nilsrenner/Self-Tuned-Filter/README.md

# Self-Tuned Filter
Backup für die Bachlorarbeit
