nilsrenner/Self-Tuned-Filter/005_Dokumentation/003_Thesis/acronyms.tex

\newacronym{pll}{PLL}{Phase-Locked Loop}%

%\newacronym{digipot}{DP}{Digitalpotentiometer}

\newacronym{opv}{OPV}{Operationsverstärker}%fertig

\newacronym{pd}{PD}{Phasendetektor}%

\newacronym{vco}{VCO}{Voltage-Controlled Oscillator}%

\newacronym{vcf}{VCF}{Voltage-Controlled Filter}%

\newacronym{pcb}{PCB}{Printed Circuit Board}%

\newacronym{mcu}{MCU}{Microcontroller Unit}%

\newacronym{gpio}{GPIO}{General Purpose Input Output}

\newacronym{spi}{SPI}{Serial Peripheral Interface}

\newacronym{adc}{ADC}{Analog Digital Converter}%

\newacronym{ui}{UI}{User Interface}

\newacronym{wlan}{WLAN}{Wireless Local Area Network}

\newacronym{eeprom}{EEPROM}{Electrically Erasable Programmable Read-Only Memory}

\newacronym{http}{HTTP}{Hypertext Transfer Protocol}

\newacronym{html}{HTML}{Hypertext Markup Language}

\newacronym{ip}{IP}{Internet Protocol}

\newacronym{ram}{RAM}{Random Access Memory}

\newacronym{gbw}{GBW}{Gain Bandwidth Product}

%\newacronym{sf}{SF}{Scale Factor}

\newacronym{ic}{IC}{Integrated Circuit}
