nilsrenner/Self-Tuned-Filter/005_Dokumentation/Vorbereitung/report/index.qmd

---
title: "Vorbereitung Bachlorarbeit"
author: 
  - name: Nils Renner
    orcid: 
    email: nrenner@stud.hs-bremen.de
    corresponding: true
    roles: "Lead author"
    affiliation:
      - name: Hochschule Bremen - City University of Applied Sciences (HSB)
        city: Bremen
        state: Germany
        url: https://www.hs-bremen.de  

keyword:
  - Filter Design 
  - PCB

abstract: |
    Lorem ipsum 

date: last-modified
number-sections: true
bibliography: references.bib
---

{{< include content/_sec_Einleitung.qmd >}}
{{< include content/_sec_Theorie_2.qmd >}}
{{< include content/_sec_Charakterisierung.qmd >}}
{{< include content/references.qmd >}}
