nilsrenner/Self-Tuned-Filter/005_Dokumentation/003_Thesis/Theorie/Theorie_alt.pdf

# Kapitel 1

# Theoretische Grundlagen

In diesem Teil werden die bislang im Studium erlangten Kenntnisse noch einmal aufgegriffen. Bei der Dokumentation dieser wurden allerdings auch immer wieder neue Erkenntnisse gewonnen.

Konventionelle Filterschaltungen basieren meist auf Kondensatoren und Induktivitäten. Während Kondensatoren sehr kompakt aufgebaut und problemlos in integrierten Schaltungen realisiert werden können, stellen Induktivitäten in dieser Hinsicht eine Herausforderung dar. Induktivitäten sind groß und lassen sich nur schwer miniaturisieren, was den Einsatz in modernen elektronischen Systemen erschwert. Zudem weisen Induktivitäten parasitäre Eigenschaften auf, die das Filterverhalten insbesondere bei höheren Frequenzen negativ beeinflussen können.

Eine gute Lösung für diese Problematik sind opv, die durch die externe Verschaltung von Kondensatoren und Widerständen die Funktion von Induktivitäten übernehmen können. Durch die geschickte Kombination dieser drei Bauelemente lassen sich vielfältige Filterstrukturen auf kleinem Raum realisieren. Filter auf Basis von opv werden als aktive Filter bezeichnet, da sie im Gegensatz zu passiven Filtern eingehende Signale verstärken können und deshalb eine externe Spannungsversorgung benötigen, um den opv mit Energie zu versorgen.[1]

1

Nils Renner (5197659) | Vorbereitung Bachelorthesis

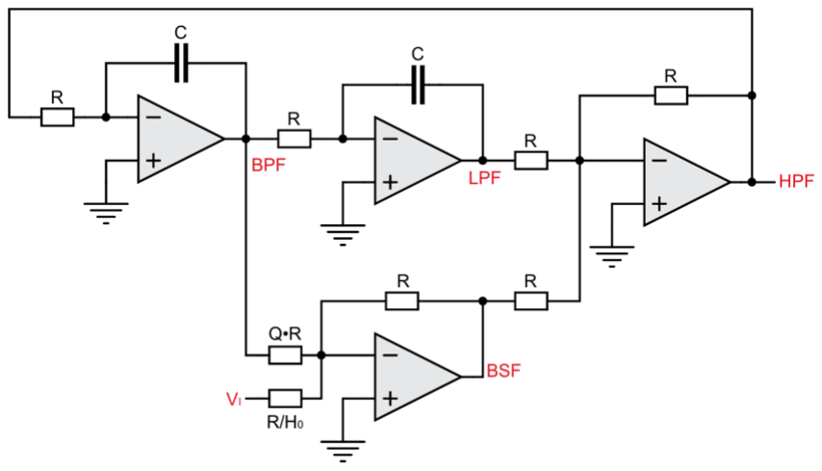
[picture p44: figure]

Abbildung 1.1: Biquadratische Filterstruktur [2]

Eine dieser aktiven Filterstrukturen ist der sogenannte Biquad-Filter, der in der Lage ist, verschiedene Filtertypen wie Tiefpass, Hochpass, Bandpass und Bandsperre innerhalb einer Schaltung bereitzustellen.

Der Biquad-Filter ist wie der Name schon andeutet ein Filter zweiter Ordnung, der aus zwei Integratoren und zwei Addierern besteht. Durch die Verschaltung dieser opv wie in Abbildung 1.1 zu erkennen, liegt am Ausgang jedes opv ein Signal vor, was eine andere Filtercharakteristik aufweist. Durch die Wahl des Ausgangs kann somit die gewünschte Filterung ausgegeben werden.

Zur mathematischen Beschreibung des Systems werden die Übertragungsfunkionen der einzelnen Filtertypen mittels der Laplace-Transformation, unter Verwendung des idealisierten opv-Modells, hergeleitet. Damit gilt für den Integrierer:

Vin

R
−

+

Vout

C

Abbildung 1.2: Invertierender Integrator

Vout(s) = −

Vin(s)
sRC | (1.1)

Und für den invertierenden Addierer:

Vout = −R2

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
(1.2)

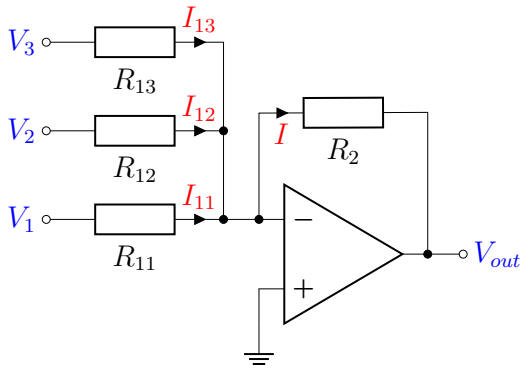
[picture p45: figure]
Vout

Abbildung 1.3: Invertierender Addierer

Durch die Kombination dieser Teilschaltungen lassen sich die Übertragungsfunktionen der einzelnen glsopv-Ausgänge herleiten. Dabei steht Q für den Gütefaktor und der Verstärkungsfaktor wird durch H0 repräsentiert.

V1 = −(V3 + V4) | (1.3)

V2 = −

1
s

ω0 · V1

| (1.4)

V3 = −

1
s

ω0 · V2

| (1.5)

V4 = −

V2
Q

+ H0 · Vi

| (1.6)

Werden diese Gleichungen so ineinander eingesetzt, dass sie dem Schaltbild des Biquad-Filters (1.1) entsprechen, lassen sich die Übertragungsfunktionen der vier Filtertypen herleiten. Die einzelnen Schritte der Herleitung werden im Abschlussbericht des Moduls ANS [3] ausführlicher besprochen.

- Tiefpass:

V3
Vi

=

H0
1 + s
ω0Q +

s

2
ω

2
0

(1.7)

- Hochpass:

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
1 + s
ω0Q +

s

2
ω

2
0

(1.8)

- Bandpass:

V2
Vi

=

−H0

s
ω0
1 + s
ω0Q +

s

2
ω

2
0

(1.9)

- Bandsperre:

V4
Vi

=

−H0

1 + s

2
ω

2/0

1 + s
ω0Q +

s

2
ω

2
0

(1.10)

Gut zu erkennen ist hierbei, dass alle Übertragungsfunktionen den gleichen Nenner besitzen. Der Zähler unterscheidet sich je nach Filterart.

## 1.1 Einfluss der Bauteilgrößen und Parameter auf das Filterverhalten

Die Werte der im Biquad eingesetzten Widerstände und Kondensatoren bestimmen die charakteristischen Größen des Filters. Insbesondere beeinflussen sie die Mittenfrequenz ω0, die Filtergüte Q und die maximale Verstärkung H0. Durch die gezielte Auswahl der Bauteilwerte lässt sich das Filterverhalten auf die spezifischen Anforderungen einer Anwendung abstimmen.

Die Mittenfrequenz ω0 ergibt sich bei idealiserten Schaltungen nach folgender Formel:

ω0 =

1
RC | (1.11)

Durch genauere Betrachtung in der Vorbereitungsphase auf diese Thesis fiel auf, dass R sich nur durch den Wert der beiden Vorwiderstände der Integratoren ergibt, nicht aber durch die Widerstände der Addierer. Dieser Zusammenhang war vorher nicht klar, weswegen im damaligen Schaltungsdesign die Kondensatoren geändert wurden (Anstatt 8 Widerstände)um die Mittenfrequenz zu verschieben. C beschreibt die Kapazität der beiden Kondensatoren in den Integratoren. Der durch die Gleichung 1.11 gezeigte Zusammenhang kann nun dafür verwendet werden, die Mittenfrequenz auf den gewünschten Wert einzustellen.

Der Gütefaktor beeinflusst im Zeitbereich die Resonanz und Dämpfung des Filters. Je nach Wert von Q lassen sich drei unterschiedliche Dämpfungsfälle anhand der Impulsantwort unterscheiden:

- Schwingfall (Q > 1
2

): Konjugiert-komplexe Pole, gedämpftes Schwingungsverhalten:

s1,2 = −

ω0
2Q

± jω0

r
1 −

1
4Q²
- Aperiodischer Grenzfall (Q =

1/2): Doppelter reeller Pol, kritische Dämpfung:

s1,2 = −ω0

- Kriechfall (Q < 1
2

): Zwei reelle Pole, träges (überdämpftes) Verhalten:

s1,2 = −

ω0
2Q

± ω0

r
1
4Q²

− 1

Die Filtergüte Q beeinflusst ebenfalls das Frequenzverhalten des Filters. Dabei unterscheidet sich der Zusammenhang zwischen Güte und Bandbreite je nach Filtertyp.

Bei Hoch- und Tiefpassfiltern charakterisiert Q die Flankensteilheit im Übergangsbereich um die Grenzfrequenz ωc. Eine Erhöhung des Gütefaktors führt zu einer steileren Filterflanke und zu einer stärkeren Dämpfung außerhalb des Durchlassbereichs. Zudem ergibt sich ab einer Güte von Q > √

1
2

eine Resonanzüberhöhung (Überschwinger) an der Mittenfrequenz.

Im Gegensatz dazu verfügen Bandpass- und Bandsperrfilter über eine deutlich ausgeprägte Mittenfrequenz ω0, welche das Zentrum des Durchlass- bzw. Sperrbereichs markiert. Die Bandbreite ∆ω beschreibt den Abstand zwischen den beiden 3 dB-Grenzfrequenzen. Die folgende Gleichung beschreibt den Zusammenhang zwischen Güte, Bandbreite und Mittenfrequenz.[4]

∆ω =

ω0
Q

(1.12)

Eine größere Güte Q führt also zu einer schmaleren Bandbreite und zu einer stärker ausgeprägten Verstärkung bzw. Dämpfung um die Mittenfrequenz.

hier könnte noch eine schöne überleitung zur NS und PS in der s-Ebene hinein. -> gehe ich darauf später noch mal ein?

Der Verstärkungsfaktor H0 wirkt sich hingegen nur auf die Amplitudenhöhe des Filters aus, ohne die Frequenzcharakteristik zu verändern. Ein höherer Verstärkungsfaktor führt zu einer stärkeren Signalverstärkung im Durchlassbereich des Filters.

sollte hier die bestimmung der Grenzfrequenz hin? => habe das allerdings zur vorbereitung gemacht und nicht im 6. Semester

## 1.2 Grenzfrequenz und Mittenfrequenz

sollte warscheinlich vor dem anderen Kapitel stehen.

Da in der Vorbereitungsphase zu dieser Thesis aufgefallen ist, dass die Begriffe Grenzfrequenz ωc und Mittenfrequenz ω0 in der Vorarbeit aus dem letzten Semester nicht immer eindeutig verwendet wurden, wird im Folgenden kurz auf deren Definition eingegangen.

Im ALSK-Pro-Manual werden für die Übertragungsfunktionen immer die Kreisfrequenzen verwendet, weswegen auch in dieser Arbeit hauptsächlich Kreisfrequenzen verwendet. Die Grenzfrequenz ωc beschreibt dabei die Kreisfrequenz, bei der der Betrag der Übertragungsfunktion eines Filters auf √

1
2

bezogen auf den Maximalwert abgefallen bzw. bei Bandsperren angestiegen ist und entspricht damit dem −3 dB-Punkt (bzw. 3 dB-Punkt bei BS) des Amplitudengangs.

Die Mittenfrequenz ω0 entspricht der Resonanzfrequenz des Filters. Bei Bandpass- und Bandsperrfiltern enspricht diese Frequenz dem Maximum bzw. Minimum des Amplitudengangs. Bei Hoch- und Tiefpässen sind Grenz- und Mittenfrequenz im Allgemeinen nicht identisch. Die Außnahme stellt dabei der Butterworth-Filter da, für diesen gilt ω0 = ωc.

Für eine Güte Q > √

1
2

ist die Mittenfrequenz auch bei Hoch- und Tiefpässen erkennbar. Dort tritt eine Resonanzüberhöhung im Amplitudengang auf, deren Maximum bei der Mittenfrequenz liegt. Beim Bandpass liegt die Mittenfrequenz im Zentrum des Durchlassbereichs, während die unteren und oberen Grenzfrequenzen die Bandbreite des Übertragungsbereichs begrenzen.
