nilsrenner/Self-Tuned-Filter/005_Dokumentation/003_Thesis/Fazit/Fazit.tex

\documentclass[../main_config.tex]{subfiles}
\begin{document}

\chapter{Fazit und Ausblick}

\end{document}
