nilsrenner/Self-Tuned-Filter/005_Dokumentation/003_Thesis/analog_multiplier/bsb_einfacher_mulitplizierer.pdf

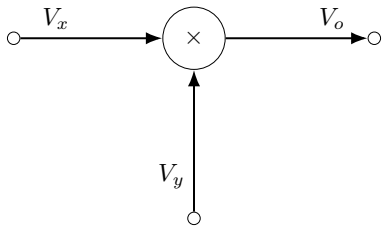
[picture p47: figure]
