nilsrenner/Self-Tuned-Filter/005_Dokumentation/003_Thesis/Theorie/bsb_produkt.pdf

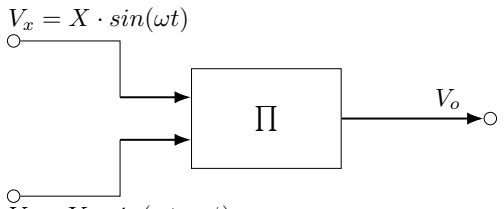
[picture p48: figure]
Vx = X · sin(ωt)

Vy = Y · sin(ωt + ϕ)
