nilsrenner/Self-Tuned-Filter/005_Dokumentation/003_Thesis/Theorie/sb_phasendetektor.pdf

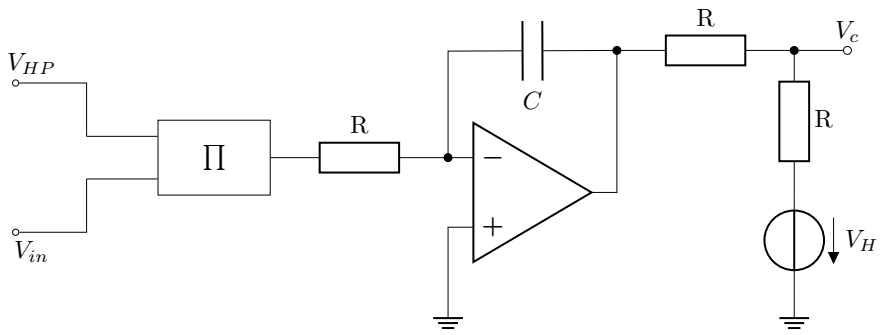
[picture p49: figure]
VHP Vin
