nilsrenner/Self-Tuned-Filter/005_Dokumentation/003_Thesis/Theorie/sb_vcintegrator.pdf

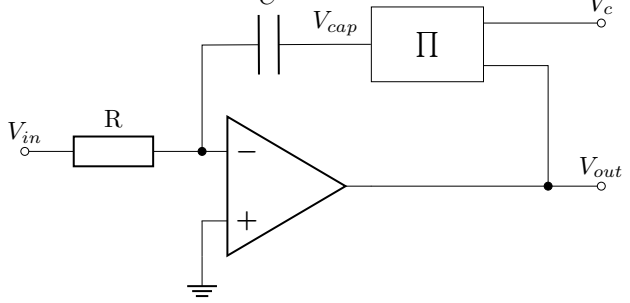
[picture p50: figure]
Vin; Vcap; Vout

C
Vc
