nilsrenner/Self-Tuned-Filter/005_Dokumentation/003_Thesis/Theorie/sb_w0_herleitung.pdf

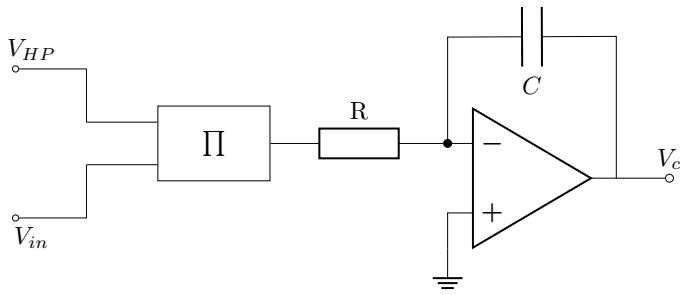
[picture p51: figure]
VHP Vin
