nilsrenner/Self-Tuned-Filter/005_Dokumentation/003_Thesis/Theorie/bsb_multi_funktionell.pdf

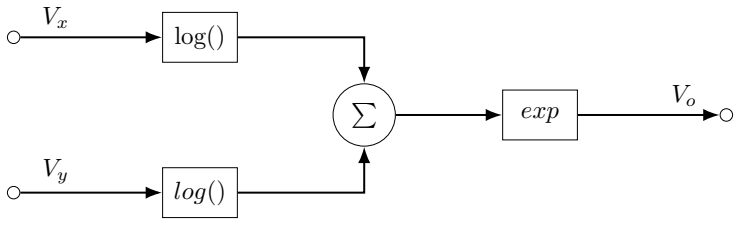
[picture p52: figure]
log(); exp
