nilsrenner/Self-Tuned-Filter/001_Simulation_und_Schaltungsentwurf/002_Symbols_and_Footprints/.svg2shenzhen-cache/images/F.SilkS_g3.png

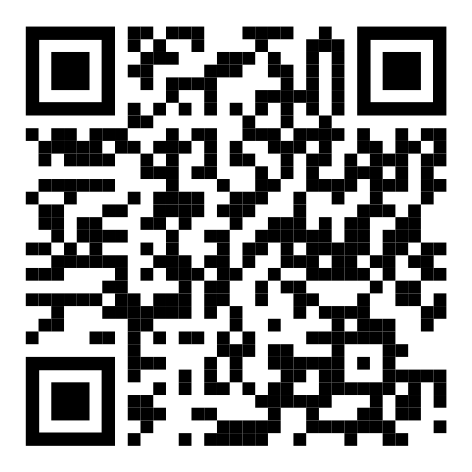
001_Simulation_und_Schaltungsentwurf/002_Symbols_and_Footprints/.svg2shenzhen-cache/images/F.SilkS_g3.png
