nilsrenner/Self-Tuned-Filter/005_Dokumentation/001_Bilder/Figure_7.png

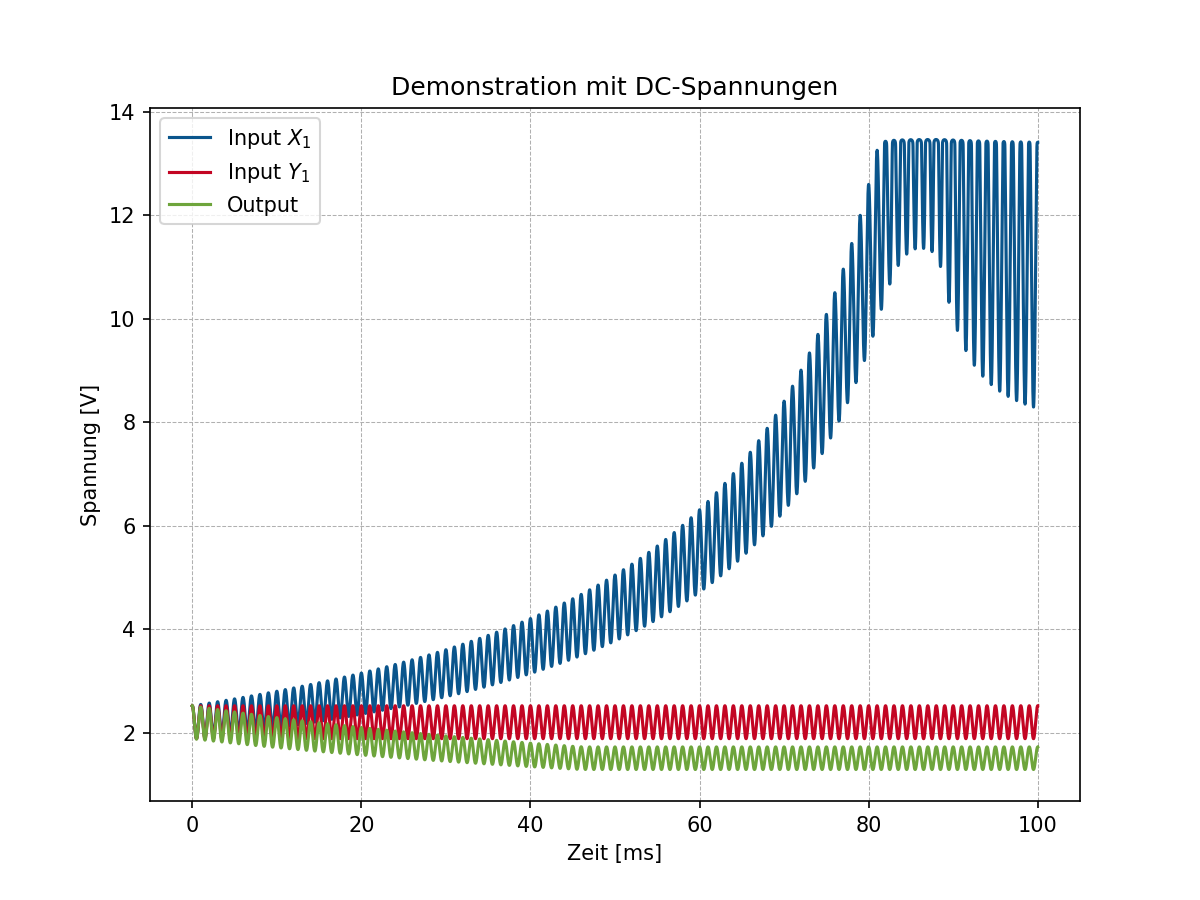
005_Dokumentation/001_Bilder/Figure_7.png
