nilsrenner/Self-Tuned-Filter/005_Dokumentation/001_Bilder/versch_freq_3.png

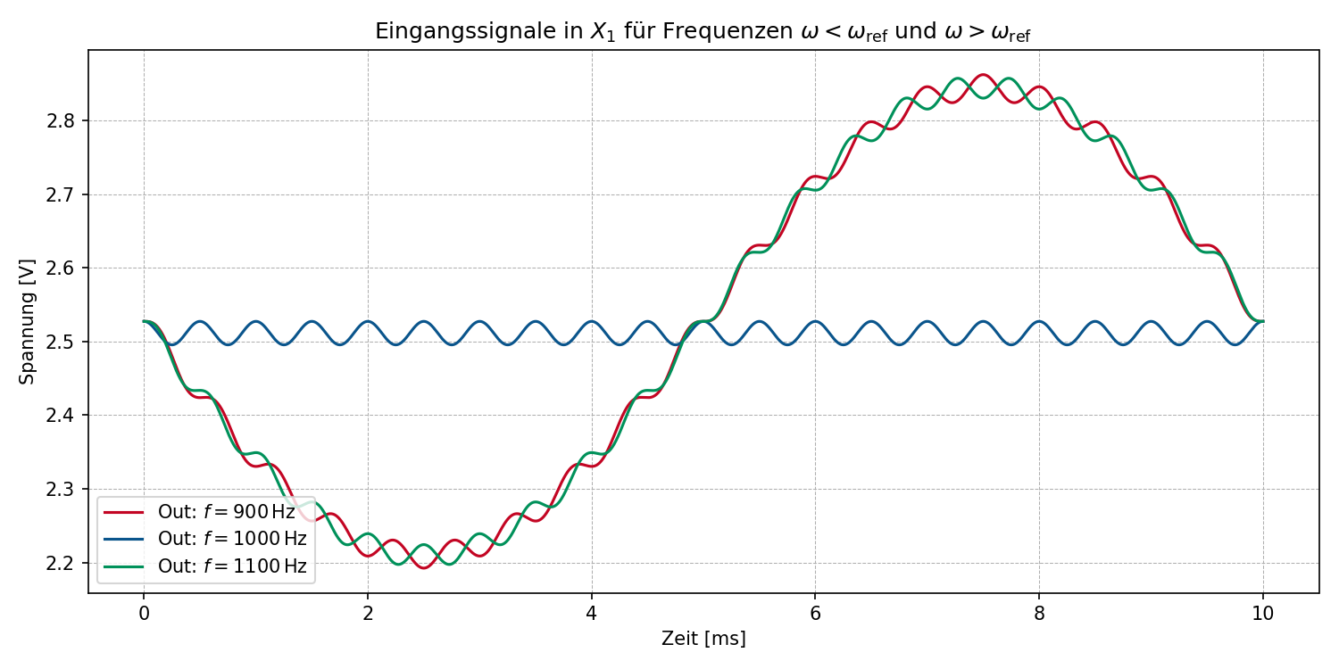
005_Dokumentation/001_Bilder/versch_freq_3.png
