nilsrenner/Self-Tuned-Filter/005_Dokumentation/002_Expose/Pictures/zp_ba.png

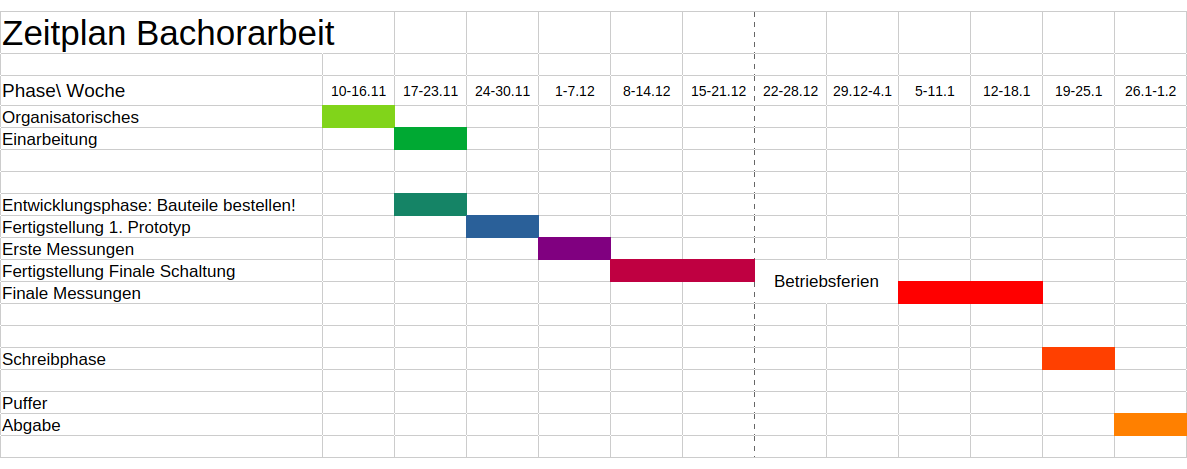
005_Dokumentation/002_Expose/Pictures/zp_ba.png
