nilsrenner/Self-Tuned-Filter/005_Dokumentation/003_Thesis/Bilder/ac_multi_pd.png

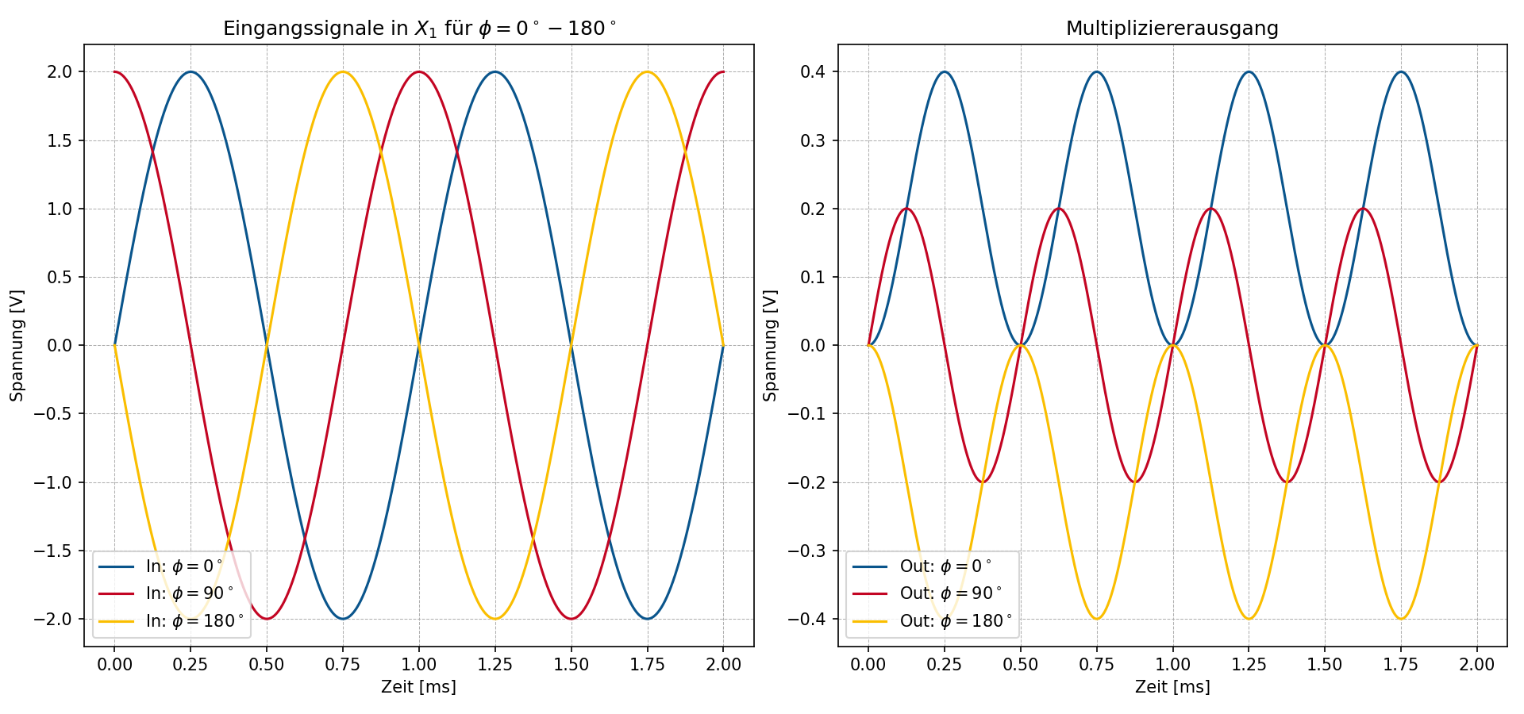
005_Dokumentation/003_Thesis/Bilder/ac_multi_pd.png
