nilsrenner/Self-Tuned-Filter/005_Dokumentation/003_Thesis/Bilder/dc_multi.png

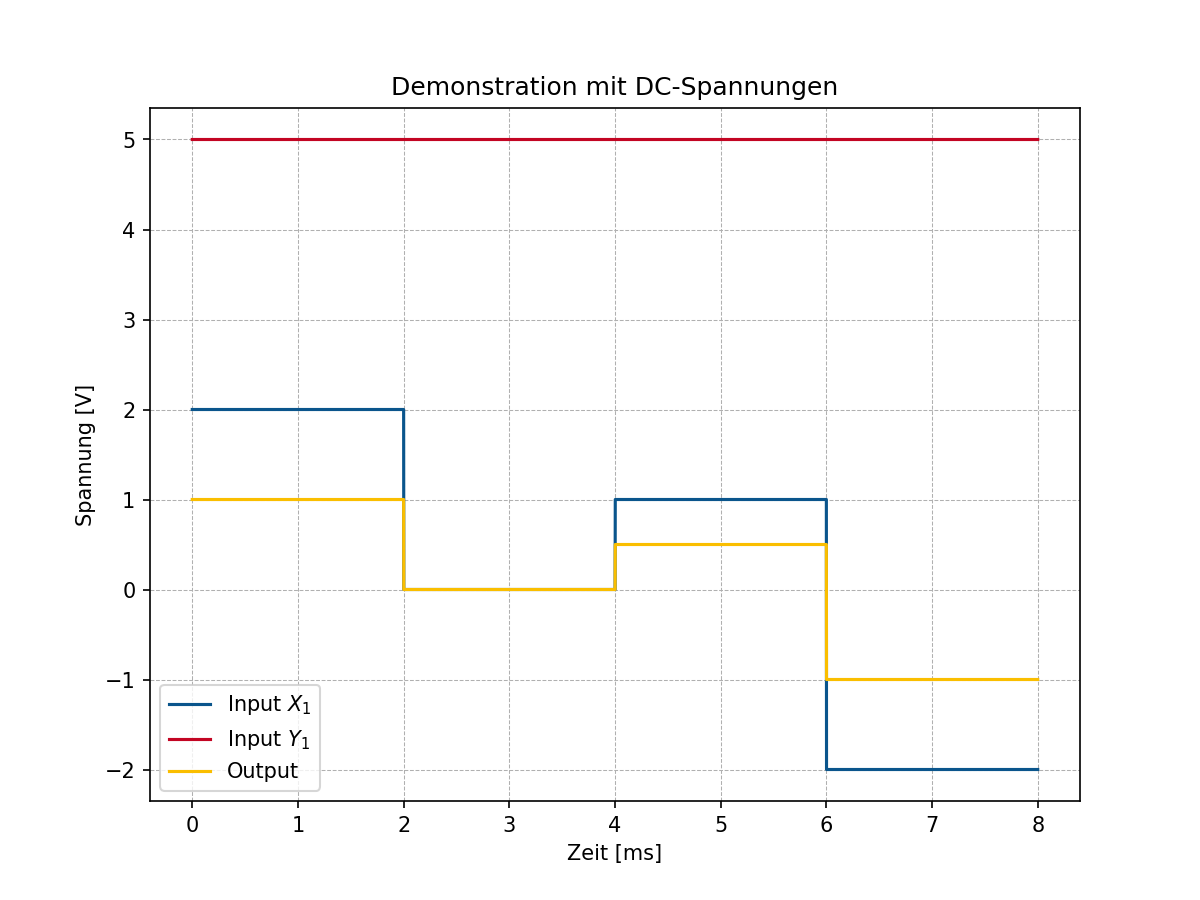
005_Dokumentation/003_Thesis/Bilder/dc_multi.png
