nilsrenner/Self-Tuned-Filter/005_Dokumentation/003_Thesis/Bilder/pd_op_out.png

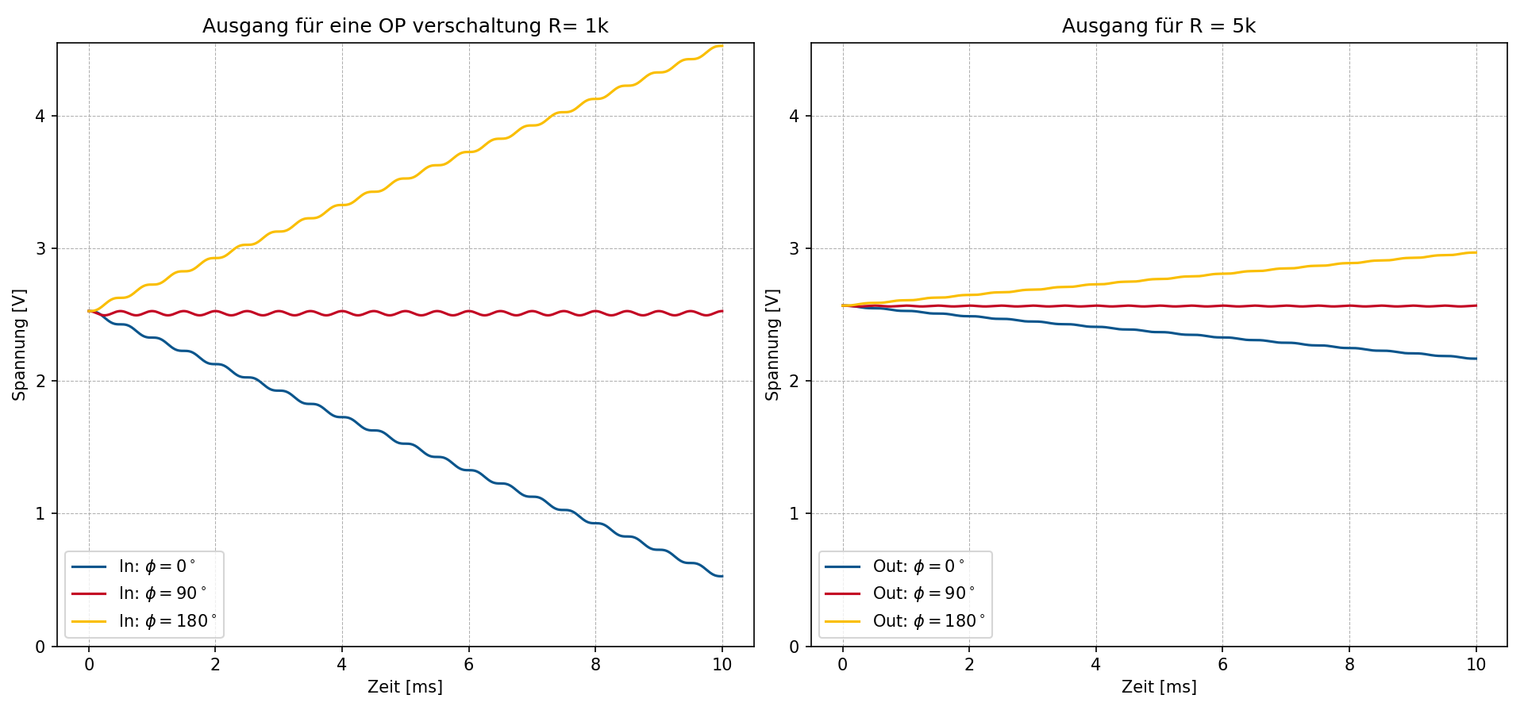
005_Dokumentation/003_Thesis/Bilder/pd_op_out.png
