nilsrenner/Self-Tuned-Filter/005_Dokumentation/003_Thesis/Bilder/phase2omega3.png

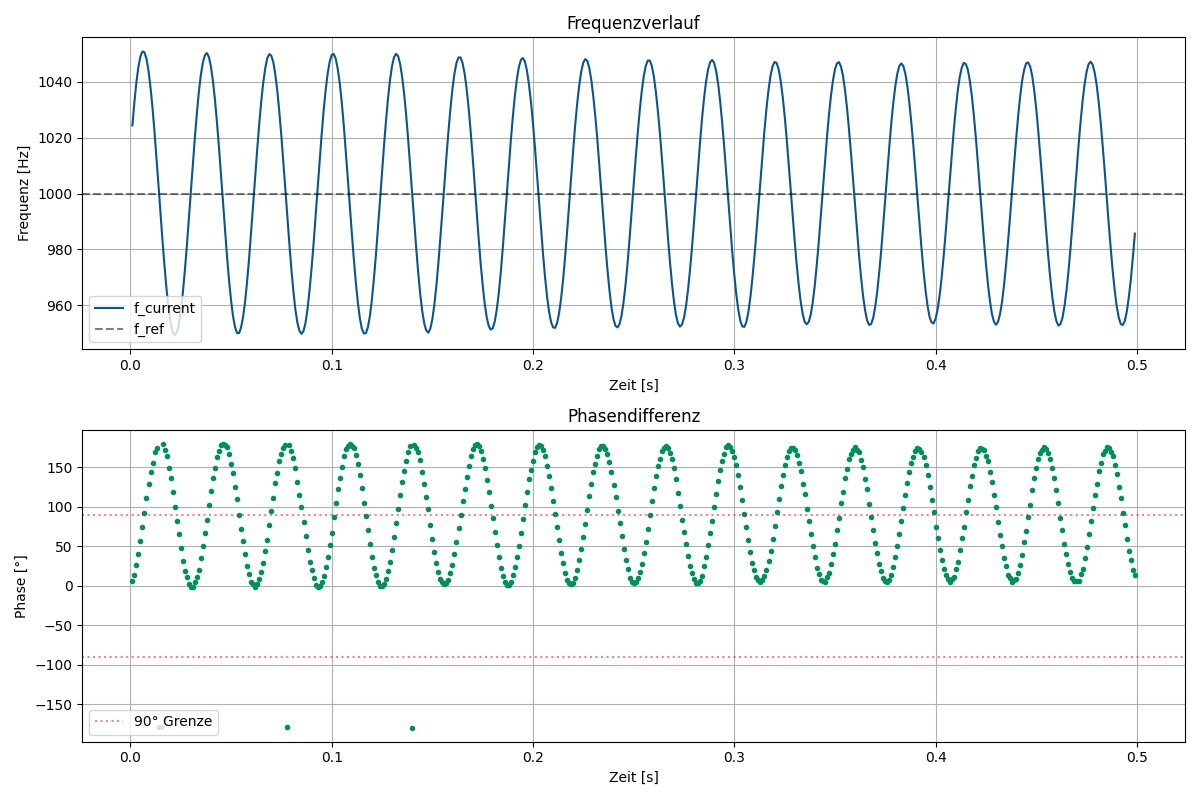
005_Dokumentation/003_Thesis/Bilder/phase2omega3.png
