nilsrenner/Self-Tuned-Filter/005_Dokumentation/003_Thesis/Bilder/phasencharakteristik_multi2.png

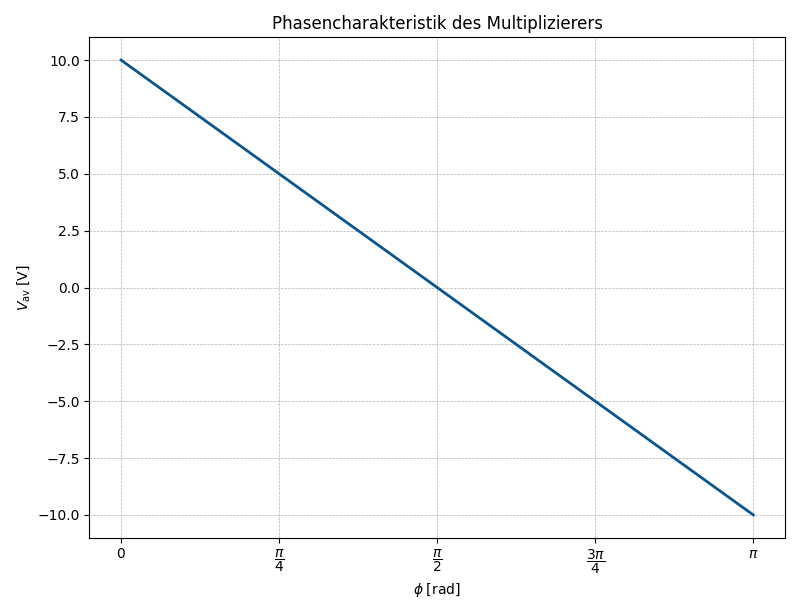
005_Dokumentation/003_Thesis/Bilder/phasencharakteristik_multi2.png
