nilsrenner/Self-Tuned-Filter/005_Dokumentation/003_Thesis/Bilder/phasengang_biquad_sem6.png

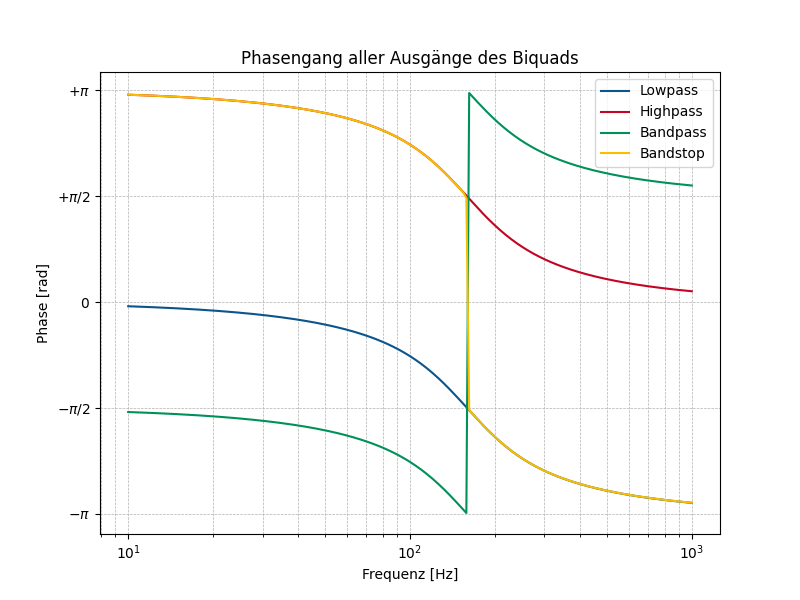
005_Dokumentation/003_Thesis/Bilder/phasengang_biquad_sem6.png
