nilsrenner/Self-Tuned-Filter/005_Dokumentation/003_Thesis/Bilder/sensitivität1.png

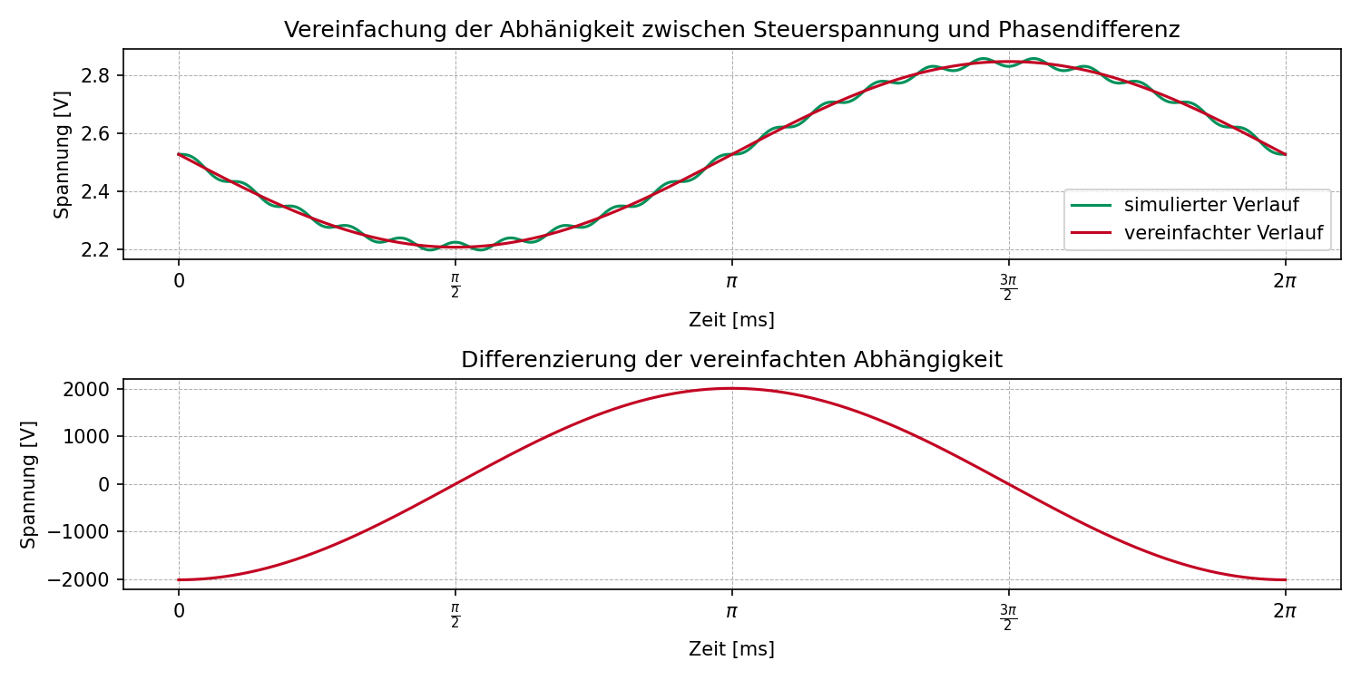
005_Dokumentation/003_Thesis/Bilder/sensitivität1.png
