nilsrenner/Self-Tuned-Filter/001_Simulation_und_Schaltungsentwurf/002_Symbols_and_Footprints/MCP4261-104E_P.step

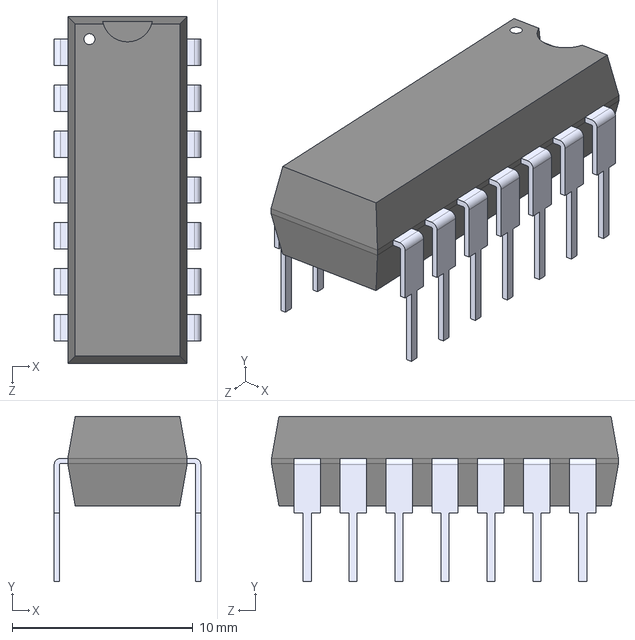
[picture p70: CAD file, 2025-10-15]
001_Simulation_und_Schaltungsentwurf/002_Symbols_and_Footprints/MCP4261-104E_P.step
8.10 x 9.14 x 19.2 mm
