nilsrenner/Self-Tuned-Filter/001_Simulation_und_Schaltungsentwurf/008_LTSpice/Experiment_05.asc

C1: cap; 200n
C2: cap; 1µ
C3: cap; 100n
R1: res; 1k
R2: res; 2k
R3: res; 1k
R4: res; 1k
R5: res; 1k
R6: res; 1k
R7: res; 64k
R8: res; 500
R9: res; 100k
R10: res; 10
R11: res; 1k
U1: opamp2; tl082
U2: opamp2; tl082
U3: opamp2; tl082
U4: opamp2; tl082
U5: mpy634
U6: mpy634
U7: mpy634
U8: opamp2; tl082
V1: voltage; PULSE(-100m 100m 0 1n 1n 500µ 1m); AC 1 0
V2: voltage; 10
V3: voltage; 10
V4: voltage; {Vx4}
VDD1: voltage; 15
VE1: voltage; 10
VSS1: voltage; 15
Named nets: 0, V+, V-, vdd, vss, ve
.ac dec 101 50 10k
.inc tl082.cir
.inc mpy634.cir
;tran 60m
.step param Vx4 1 100 20
