nilsrenner/Self-Tuned-Filter/001_Simulation_und_Schaltungsentwurf/008_LTSpice/Experiment_05_DC_VF3.asc

C1: cap; {C}
C2: cap; {C}
C3: cap; {Cx3}
R1: res; {R}
R2: res; {R}
R3: res; 1k
R4: res; {R_C}
R5: res; 1k
R6: res; 1k
R7: res; 10k
R8: res; 100k
R9: res; 1k
R10: res; 100
R11: res; 10
U1: opamp2; tl082
U2: opamp2; tl082
U3: opamp2; tl082
U4: opamp2; tl082
U5: opamp2; tl082
U6: mpy634
U7: mpy634
U8: mpy634
V3: voltage; 2.8
V_OP+: voltage; 10
V_OP-: voltage; 10
VDD1: voltage; 10
VE1: voltage; 10
VG1: voltage; PULSE(-100m 100m 0 1n 1n 500µ 1m); AC 1 0
VSS1: voltage; 10
Named nets: 0, V+, V-, vdd, vss, ve, V_F1, V_F2, V_TP, V_HP, V_F3
;ac dec 1001 50 25k
.inc tl082.cir
.inc mpy634.cir
.tran 0 1.5 0
;step param R_C list 1k 25k 100k
.param C = 650n R = 1k Cx3 = 100n R_C = 1k
;dc V3 0 5 0.1
