nilsrenner/Self-Tuned-Filter/001_Simulation_und_Schaltungsentwurf/008_LTSpice/Integrator mit Quelle am Ausgang.asc

C1: cap; 1µ
R1: res; 100
R2: res; 10
R3: res; 10k
U1: opamp2; tl082
V1: voltage; 1
V_OP1: voltage; 10
V_OP2: voltage; 10
VG1: voltage; PULSE(-100m 100m 0 1n 1n 500µ 1m); AC 1 0
Named nets: 0, V+, V-, V_F3, VG1
.tran 0 100m 0
.inc tl082.cir
