nilsrenner/Self-Tuned-Filter/001_Simulation_und_Schaltungsentwurf/Schaltungsentwurf_v2/Schaltungsentwurf_v2/Schaltungsentwurf_v2.kicad_pcb

## KiCad design 001_Simulation_und_Schaltungsentwurf/Schaltungsentwurf_v2/Schaltungsentwurf_v2/Schaltungsentwurf_v2.kicad_pcb (2026-01-26)

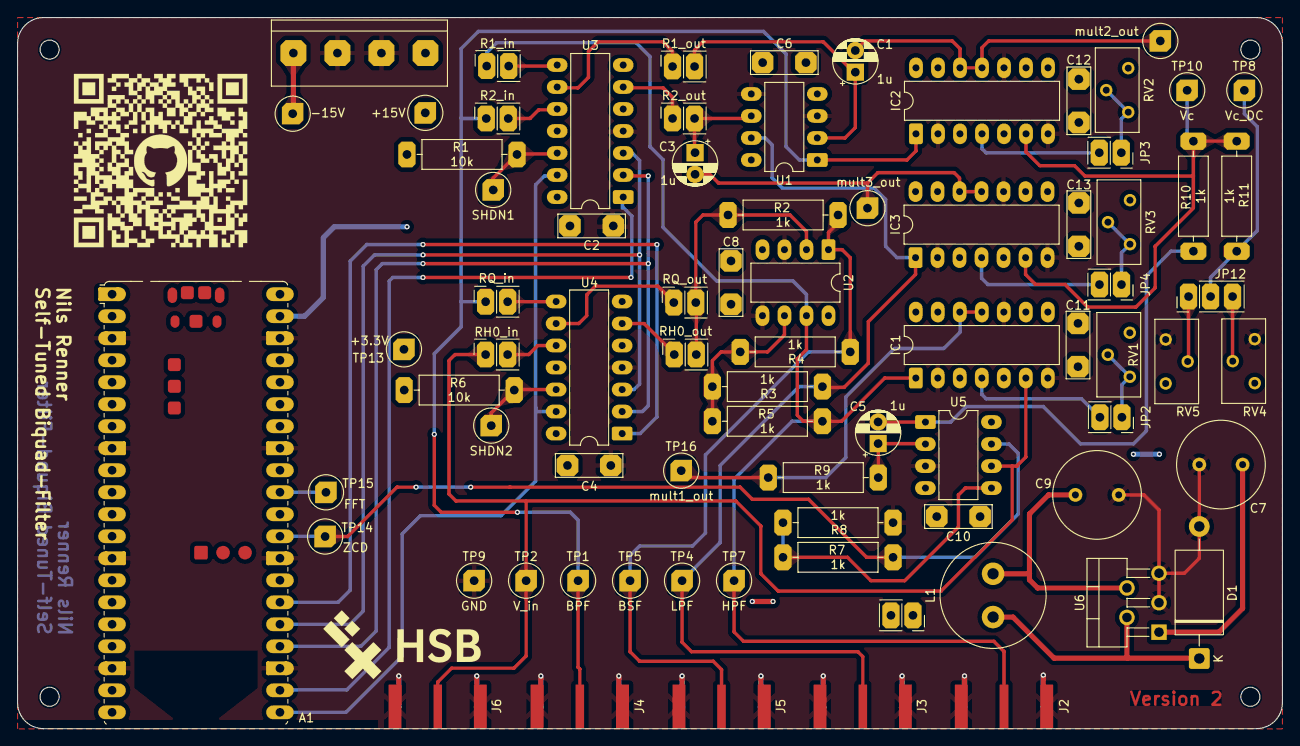
[picture p71: board Schaltungsentwurf_v2.kicad_pcb from above]

Board: 4 copper layers, 146.0 x 82.1 mm, 84 parts (1 on the bottom side), 48 nets.

Parts:
A1: RaspberryPi_Pico_W; RaspberryPi_Pico_W_THT
C1, C3, C5: 1u; 1-10uF
C2, C4, C6, C8, C10, C11, C12, C13: 100n; 100nF
C7: 470uF; C_Radial_D10.0mm_H16.0mm_P5.00mm
C9: 330uF; C_Radial_D10.0mm_H16.0mm_P5.00mm
D1: 1N5820; D_DO-27_P15.24mm_Horizontal
H1, H2, H3, H4: MountingHole; MountingHole_2.2mm_M2_DIN965
IC1, IC2, IC3: MPY634KP; DIP_14
J1: Screw_Terminal_01x04; Terminal 4 Pol
J2, J3, J4, J5, J6: Conn_Coaxial; BNC Edge Mount
JP1: R1_in; Connector 2 Pin 2.54mm
JP2, JP3, JP4, JP13: Connector 2 Pin 2.54mm
JP5: R1_out; Connector 2 Pin 2.54mm
JP6: R2_in; Connector 2 Pin 2.54mm
JP7: RQ_in; Connector 2 Pin 2.54mm
JP8: RH0_in; Connector 2 Pin 2.54mm
JP9: R2_out; Connector 2 Pin 2.54mm
JP10: RQ_out; Connector 2 Pin 2.54mm
JP11: RH0_out; Connector 2 Pin 2.54mm
JP12: Jumper3; Connector 3 Pin 2,54mm
L1: 68uH; L_Radial_D12.0mm_P5.00mm_Fastron_11P
R1, R6: 10k; Resistor
R2, R3, R4, R5, R7, R8, R9, R10, R11: 1k; Resistor
RV1, RV2, RV3: 10k; Potentiometer_Bourns_3296Y_Vertical
RV4, RV5: 100k; Potentiometer_Bourns_3296Y_Vertical
Ref**: Val**; git_qr
Ref**#2: Val**; logo_nils
TP1: BPF; TestPoint
TP2: V_in; TestPoint
TP3: SHDN1; TestPoint
TP4: LPF; TestPoint
TP5: BSF; TestPoint
TP6: SHDN2; TestPoint
TP7: HPF; TestPoint
TP8: Vc_DC; TestPoint
TP9: GND; TestPoint
TP10: Vc; TestPoint
TP11: +15V; TestPoint
TP12: -15V; TestPoint
TP13: +3.3V; TestPoint
TP14: ZCD; TestPoint
TP15: FFT; TestPoint
TP16: mult1_out; TestPoint
TP17: mult2_out; TestPoint
TP18: mult3_out; TestPoint
U1, U2, U5: TL082; DIP_8
U3, U4: MCP4261-104E_P; DIP_14
U6: LM2596T-3.3; TO-220-5_P3.4x3.7mm_StaggerOdd_Lead3.8mm_Vertical

Connections:
+3.3V: A1.39 (VSYS), C2.1, C4.1, JP13.2 (B), R1.1, R6.1, TP13.1, U3.14 (VDD), U4.14 (VDD)
+15V: C6.1, C7.1, C8.1, C10.1, C11.1, C12.1, C13.1, IC1.14 (+VS), IC2.14 (+VS), IC3.14 (+VS), J1.1, RV4.1, TP11.1, U1.8 (V+), U2.8 (V+), U5.8 (V+), U6.1 (VIN)
-15V: C6.2, C8.2, C10.2, C11.2, C12.2, C13.2, IC1.8 (-VS), IC2.8 (-VS), IC3.8 (-VS), J1.4, RV1.3, RV2.3, RV3.3, RV5.3, TP12.1, U1.4 (V-), U2.4 (V-), U5.4 (V-)
/FFT: A1.31 (GPIO26_ADC0), TP15.1
/ZCD: A1.29 (GPIO22), R7.2, TP14.1, U5.7
BPF: IC2.1 (X_1_INPUT), J4.1 (In), JP6.1 (A), JP7.1 (A), TP1.1, U1.1
BSF: J5.1 (In), R2.2, R4.1, TP5.1, U2.1
CS1: A1.22 (GPIO17), U3.1 (~CS)
CS2: A1.26 (GPIO20), U4.1 (~CS)
GND: A1.3 (GND), A1.8 (GND), A1.13 (GND), A1.18 (GND), A1.23 (GND), A1.28 (GND), A1.33 (AGND), A1.38 (GND), C2.2, C4.2, C7.2, C9.2, D1.2 (A), IC1.2 (X_2_INPUT), IC1.7 (Y_2_INPUT), IC1.10 (Z_2_INPUT), IC2.2 (X_2_INPUT), IC2.7 (Y_2_INPUT), IC2.10 (Z_2_INPUT), IC3.2 (X_2_INPUT), IC3.7 (Y_2_INPUT), IC3.10 (Z_2_INPUT), J1.2, J1.3, J2.2 (Ext), J3.2 (Ext), J4.2 (Ext), J5.2 (Ext), J6.2 (Ext), R8.1, RV4.3, RV5.1, TP9.1, U1.3 (+), U1.5 (+), U2.3 (+), U2.5 (+), U3.4 (VSS), U4.4 (VSS), U5.3 (+), U6.3 (GND), U6.5 (~ON/OFF)
HPF: IC1.1 (X_1_INPUT), J2.1 (In), JP1.1 (A), R5.2, TP7.1, U2.7
LPF: IC3.1 (X_1_INPUT), J3.1 (In), R3.1, TP4.1, U1.7
MISO: A1.21 (GPIO16), U3.13 (SDO), U4.13 (SDO)
MOSI: A1.25 (GPIO19), U3.3 (SDI), U4.3 (SDI)
unnamed: C5.2, R10.1, U5.1
unnamed: D1.1 (K), L1.1, U6.2 (OUT)
unnamed: IC1.4 (SCALE_FACTOR), JP2.2 (B)
unnamed: IC2.4 (SCALE_FACTOR), JP3.2 (B)
unnamed: IC3.4 (SCALE_FACTOR), JP4.2 (B)
unnamed: JP2.1 (A), RV1.1, RV1.2
unnamed: JP3.1 (A), RV2.1, RV2.2
unnamed: JP4.1 (A), RV3.1, RV3.2
unnamed: C1.1, JP5.2 (B), U1.2 (-)
unnamed: C3.1, JP9.2 (B), U1.6 (-)
unnamed: JP10.2 (B), JP11.2 (B), R2.1, U2.2 (-)
unnamed: JP12.1 (A), RV5.2
unnamed: JP12.3 (B), RV4.2
unnamed: JP12.2 (C), R11.2, TP8.1
unnamed: C9.1, JP13.1 (A), L1.2, U6.4 (FB)
unnamed: R3.2, R4.2, R5.1, U2.6 (-)
unnamed: R1.2, TP3.1, U3.12 (~SHDN)
unnamed: R6.2, TP6.1, U4.12 (~SHDN)
unnamed: C5.1, R9.2, U5.2 (-)
unnamed: R7.1, R8.2, U5.5 (+)
R1_in: JP1.2 (B), U3.8 (P0A)
R1_out: JP5.1 (A), U3.9 (P0W)
R2_in: JP6.2 (B), U3.10 (P0B)
R2_out: JP9.1 (A), U3.6 (P1W)
RH0_in: JP8.2 (B), U4.10 (P0B)
RH0_out: JP11.1 (A), U4.6 (P1W)
RQ_in: JP7.2 (B), U4.8 (P0A)
RQ_out: JP10.1 (A), U4.9 (P0W)
SCK: A1.24 (GPIO18), U3.2 (SCK), U4.2 (SCK)
V_in: IC1.6 (Y_1_INPUT), J6.1 (In), JP8.1 (A), TP2.1, U5.6 (-)
Vc: IC2.6 (Y_1_INPUT), IC3.6 (Y_1_INPUT), R10.2, R11.1, TP10.1
mult1_out: IC1.11 (Z_1_INPUT), IC1.12 (OUTPUT), R9.1, TP16.1
mult2_out: C1.2, IC2.11 (Z_1_INPUT), IC2.12 (OUTPUT), TP17.1
mult3_out: C3.2, IC3.11 (Z_1_INPUT), IC3.12 (OUTPUT), TP18.1
