nilsrenner/Self-Tuned-Filter/001_Simulation_und_Schaltungsentwurf/003_analog_multiplier/hilfe_der_hilfe/hilfe_der_hilfe.kicad_sch

## KiCad design 001_Simulation_und_Schaltungsentwurf/003_analog_multiplier/hilfe_der_hilfe/hilfe_der_hilfe.kicad_sch (2025-10-06)

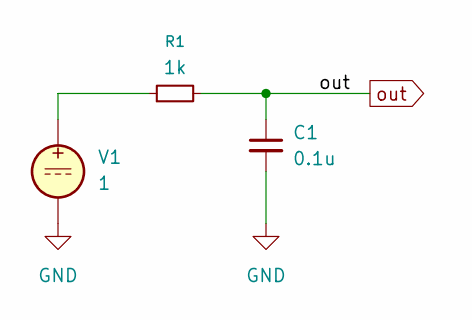
[picture p72: schematic hilfe_der_hilfe.kicad_sch]

Parts:
C1: 0.1u
R1: 1k
V1: 1

Connections:
GND: C1.2, V1.2
unnamed: R1.1, V1.1
out: C1.1, R1.2
