nilsrenner/Self-Tuned-Filter/(commit log)

2025-10-06 Ordnerstruktur und Dateien angepasst
    [2025-06-17_Mag_dB_BP.csv, 2025-06-17_Mag_dB_BP_Q10_H01.csv, 2025-06-17_Mag_dB_BP_Q1_H01.csv, 2025-06-17_Mag_dB_BS_Q10_H01.csv, 2025-06-17_Mag_dB_BS_Q1_H01.csv, 2025-06-17_Mag_dB_HP.csv, 2025-06-17_Mag_dB_HP_Q10_H01.csv, 2025-06-17_Mag_dB_HP_Q1_H01.csv]
2025-10-09 Weiterarbeit an Sim Plots
    [analog_multiplier.kicad_sch]
2025-10-13 Überarbeitung von SP und Plots
    [Schaltungsentwurf_v1.kicad_sch, analog_multiplier.kicad_sch]
2025-10-15 Weiterarbeit Stand 14.10
    [MCP4261-104E_P.step, Raspberrypi pico2 W.step, Schaltungsentwurf_v1.kicad_pcb, Schaltungsentwurf_v1.kicad_sch, analog_multiplier.kicad_pcb, analog_multiplier.kicad_sch, hilfe_der_hilfe.kicad_pcb, hilfe_der_hilfe.kicad_sch]
2025-10-20 Weiterarbeit Stand 20.10
    [Schaltungsentwurf_v1.kicad_pcb, Schaltungsentwurf_v1.kicad_sch, analog_multiplier.kicad_sch]
2025-10-24 Weiterarbeit Stand 24.10 (angepasste Dateigröße)
    [analog_multiplier.kicad_sch]
2025-10-24 Stand 24.10
    [007_simulation_VCI.kicad_pcb, 007_simulation_VCI.kicad_sch, analog_multiplier.kicad_sch, selfe_tuned_filter.kicad_sch]
2025-11-04 Stand 04.11
    [selfe_tuned_filter.kicad_sch]
2025-11-10 Expose und Aux-Datein ge-cleaned
2025-11-10 Lokale Änderungen am KiCad-Projekt gesichert
    [Schaltungsentwurf_v1.kicad_sch, selfe_tuned_filter.kicad_sch]
2025-11-14 Stand 14.11
    [Schaltungsentwurf_v1.kicad_pcb, Schaltungsentwurf_v1.kicad_sch, selfe_tuned_filter.kicad_sch]
2025-11-19 Aktueller Stand des Schreibteils hinzugefügt
2025-11-25 Erste Iteration des PCBs
    [Schaltungsentwurf_v1.kicad_pcb, Schaltungsentwurf_v1.kicad_sch]
2025-12-08 documentation of the PCB (iteration 1)
    [Schaltungsentwurf_v1.kicad_pcb, Schaltungsentwurf_v1.kicad_sch, analog_multiplier.kicad_sch]
2026-01-05 First version of the SPI bus implementation in MicroPython
2026-01-07 Rename and review of 005_self
    [self_tuned_filter.kicad_pcb, self_tuned_filter.kicad_sch]
2026-01-07 ngspice review 005_self-tuned-filter sim
2026-01-09 Konflikt aufgelöst: Theorie_neu.tex übernommen
    [Schaltungsentwurf_v1.kicad_pcb]
2026-01-09 LTspice sim added
    [analog_multiplier.kicad_sch]
2026-01-21 Schaden der letzten 10 Tage wieder rückgängig gemacht
2026-01-26 Bestätigung der Gleichung für omega_0
    [Schaltungsentwurf_v2.kicad_pcb, Schaltungsentwurf_v2.kicad_sch, self_tuned_filter.kicad_sch]
